Tympan/Earpiece_BTE-RIC_V1/ReadMe.md

# Tympan Behind The Ear Units

This repo contains hardware designs for Tympan compatible BTE units.
