Tympan/Earpiece_BTE-RIC_V1/Electrical Design/KICAD_ BTE_FLEX/Amphenol 10062827-1273992 Design Spec.pdf

PDM: Rev:C | Released | . STATUS: | Printed: Nov 28, 2010
