Tympan/Earpiece_BTE-RIC_V1/Electrical Design/KICAD_ BTE_FLEX/Tympan BTE Flex.png

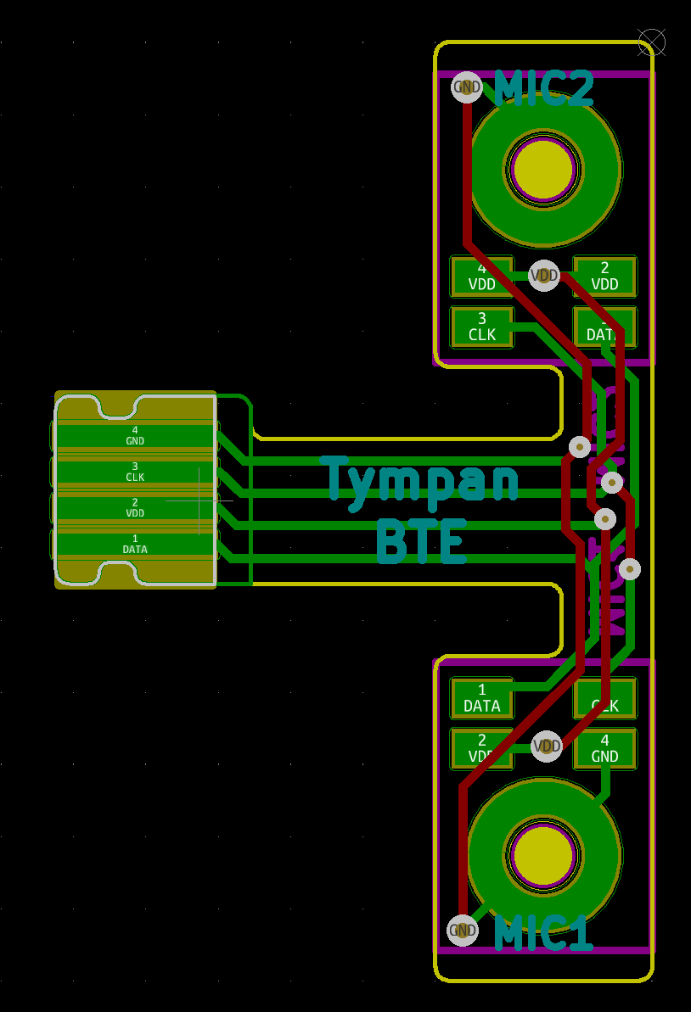
Electrical Design/KICAD_ BTE_FLEX/Tympan BTE Flex.png
