Tympan/Earpiece_BTE-RIC_V1/Photos/Tympan_Earpieces_02.jpg

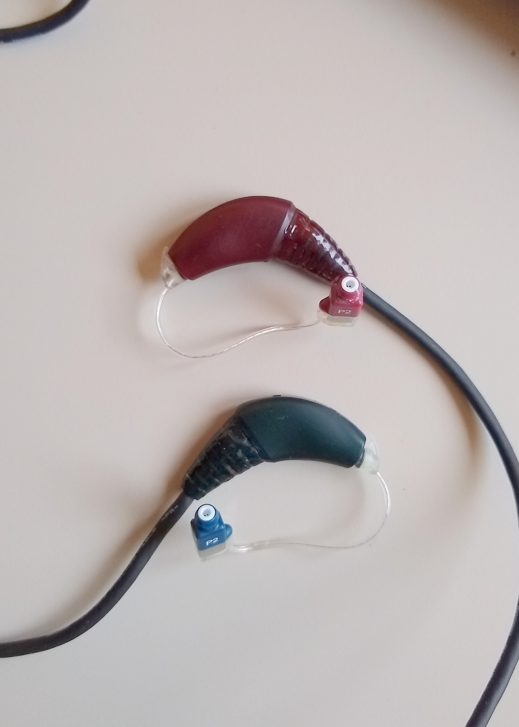
Photos/Tympan_Earpieces_02.jpg
