Tympan/Earpiece_BTE-RIC_V1/Photos/Tympan_Earpieces_04.jpg

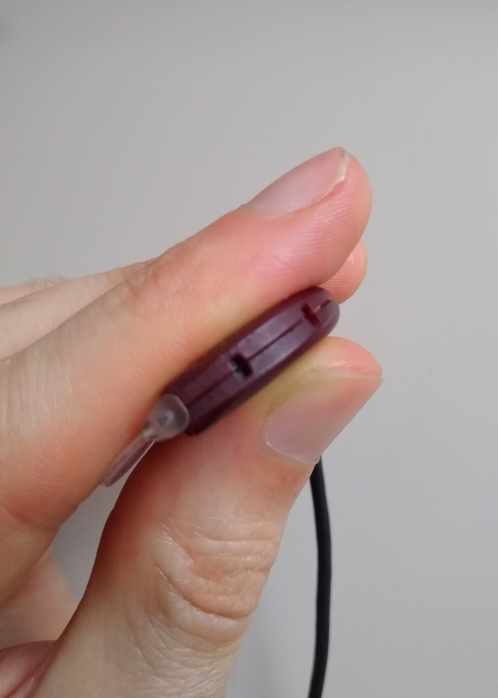
Photos/Tympan_Earpieces_04.jpg
