Tympan/Earpiece_BTE-RIC_V1/Renders/BTE-RIC-RevA.png

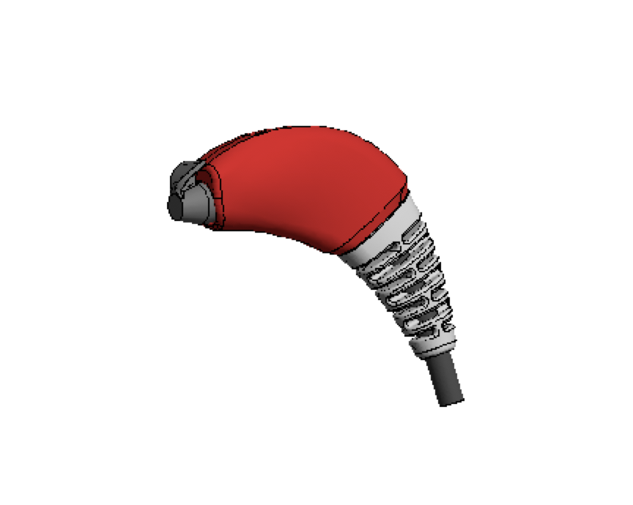
Renders/BTE-RIC-RevA.png
