Tympan/Earpiece_BTE-RIC_V1/Renders/Section_View_of_Mic_Ports.JPG

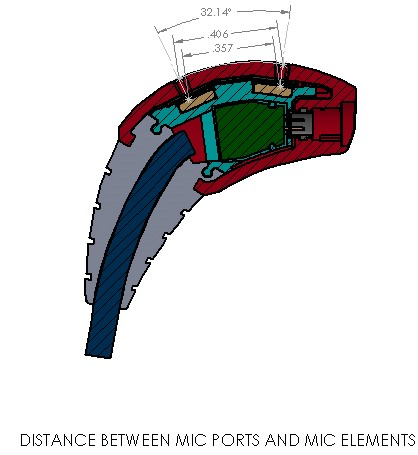
Renders/Section_View_of_Mic_Ports.JPG
