Tympan/Earpiece_BTE-RIC_V1/Renders/Tympan_BTE_Earpiece_Render-01.tif

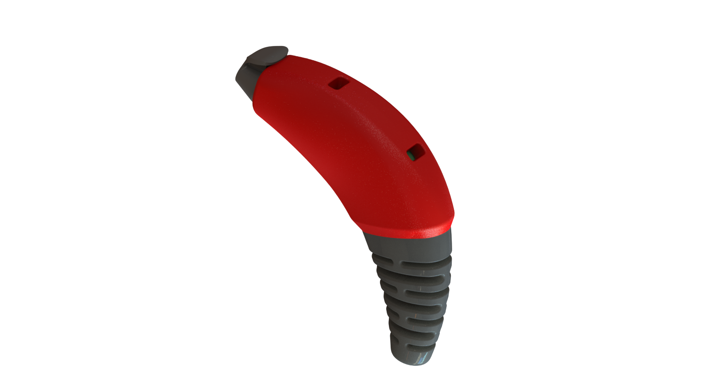
Renders/Tympan_BTE_Earpiece_Render-01.tif
