Tympan/Earpiece_BTE-RIC_V1/Renders/Tympan_BTE_Earpiece_Render-02.jpg

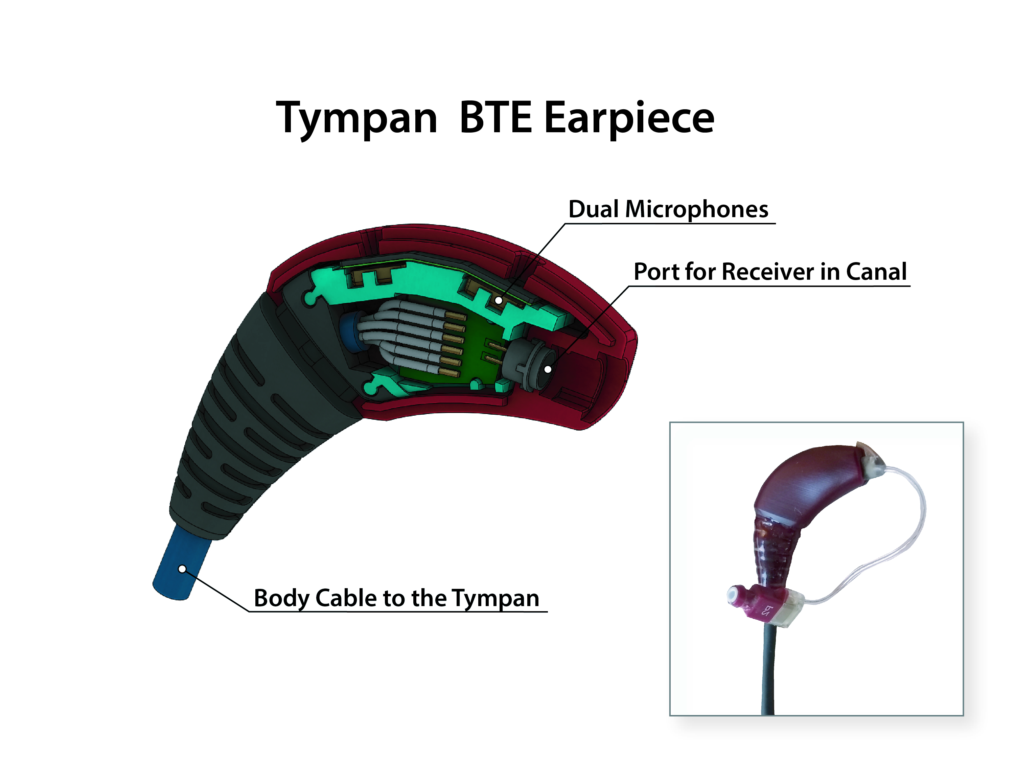
Renders/Tympan_BTE_Earpiece_Render-02.jpg
