Tympan/Earpiece_BTE-RIC_V1/Bill of Materials/BOM-7146-0100_BTE_Assembly.xlsx

Bill of Materials
BTE Earpieces
Project: Cool-Aid
Creare
Revision: C
Revised: 3/1/2021
Approved: EYUAN
Bill of Materials
Line | P/N | Description | Rev | Status | Manufacturer | Manuf. P/N | Vendor | Vendor P/N | Contact | Cost | QT per Earpiece | Notes
1 | 7146-01000 | BTE Assembly | B |  |  |  |  |  |  |  | 1
2 | 7146-01014 | BTE Enclosure_Left | A |  |  |  |  |  |  |  | 1
3 | 7146-01015 | BTE Enclosure_Right | B |  |  |  |  |  |  |  | 1
4 | 7146-01008 | Plastic Carrier | 0.1 |  |  |  |  |  |  |  | 1
5 | 7146-01003 | BTE Flex Circuit | E |  |  |  |  |  |  |  | 1 | 0.12mm thickness
6 | 7146-01017 | Mic_PDM | - |  | Infineon | IM69D130V01XTSA1 | Mouser | 726-IM69D130V01XTSA1 |  | $2.20 | 2
7 | 7146-01006 | Mic Gasket | D |  |  |  |  |  |  |  | 1
8 | 7146-01007 | BTE Rigid PCB Assy | C |  |  |  |  |  |  |  | 1
9 | 7146-01005 | Receiver Socket_CS44_PCBMount_RigidHousing12_BLK | - |  | Sonion | 4400-3112255 | Sonion | 4400-3112255 | Greg Hovland ggh@sonion.com Mobile: +1 507-269-8395 | $2.59 | 1 | PCB pins
10 | 7146-01013 | FPC Connector_4pos_0p5 pitch | - |  | Amphenol | 10062827-0410EDHLF (https://www.amphenol-icc.com/flex-0-5-vlp-100628270410edhlf.html) | Mouser | 649-100628270410EDHL (https://www.mouser.com/ProductDetail/Amphenol-FCI/10062827-0410EDHLF) |  | $0.28 | 1
11 | 7146-01008 | Body Cable Assy | H |  |  |  |  |  |  |  | 1
12 | 7146-01011 | USB Mini-B Connector_5-wire_Shielded | -
13 | 7146-01004 | Body Cable_6pos_33AWG_2.5mmOD | - |  | Mogami | W2880 | Redco | W2880 (https://www.redco.com/Mogami-W2880.html) | Phil Tennison phil@mogamicable.com Office: 310-333-0606 x 1112 Cell: 310-469-2890 | $0.85 | 3ft | Redco currently has 1000ft stock with no min order
14a | 7146-01001 | RIC_Knowles_FK Series_Size2_Right_WindScreen | - |  | Knowles | RVA-90020-NXX | In’Tech | 99A-3048106001 |  | $36.44 | 1 | 118ohm @1kHz: High Bandwidth
14b | 7146-01002 | RIC_Knowles_FK Series_Size2_Left_WindScreen | - |  | Knowles | RVA-90020-NXX | In’Tech | 99A-3048106002 |  | $36.44 | 1 | 118ohm @1kHz: High Bandwidth
15 | 7146-01016 | RIC Dome_Medium | - |  | N/A | N/A | In’Tech | 99A-1095426000 |  | $1.00 | 1
