Tympan/Earpiece_BTE-RIC_V1/Electrical Design/KICAD_ BTE_FLEX/Tympan_BTE_Flex_BOM.csv

Reference | Quantity | Value | Footprint | Manufacturer | Part Number
MIC1 MIC2 | 2 | IM69D130 | Tympan_BTE_Flex:IM69D130 | Infineon | IM69D130V01XTSA1
