Tympan/Earpiece_BTE-RIC_V1/Photos/Tympan_Earpiece_Components.jpg

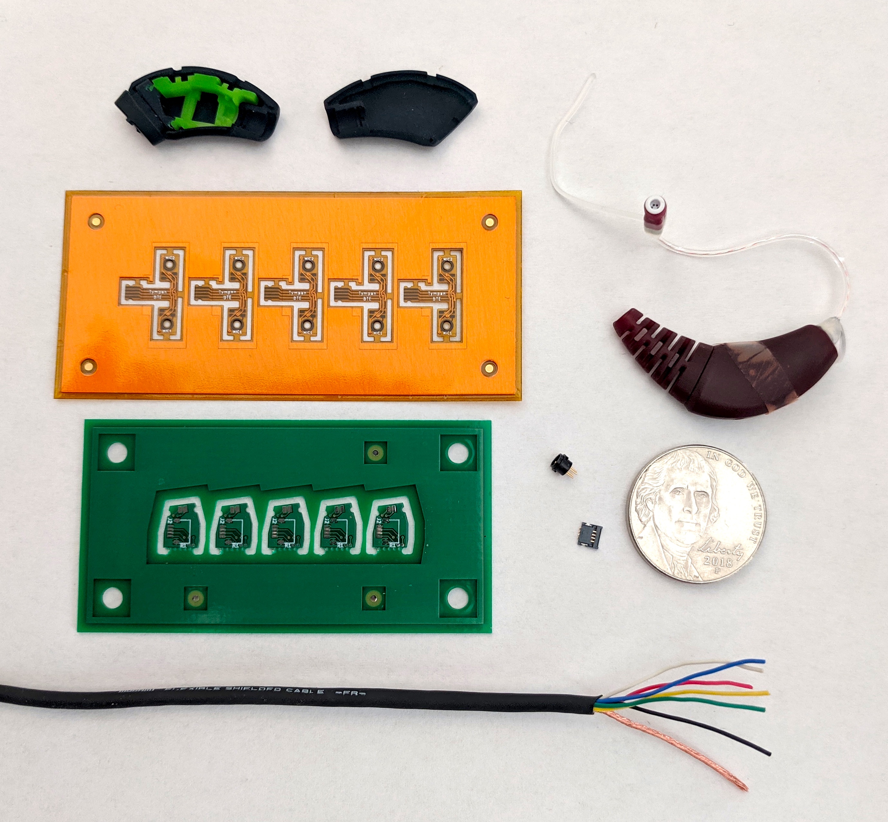
Photos/Tympan_Earpiece_Components.jpg
