Tympan/Earpiece_BTE-RIC_V1/Mechanical Design/Exported Geometry/7146-01006_MIC_GASKET__Rev-F.DXF

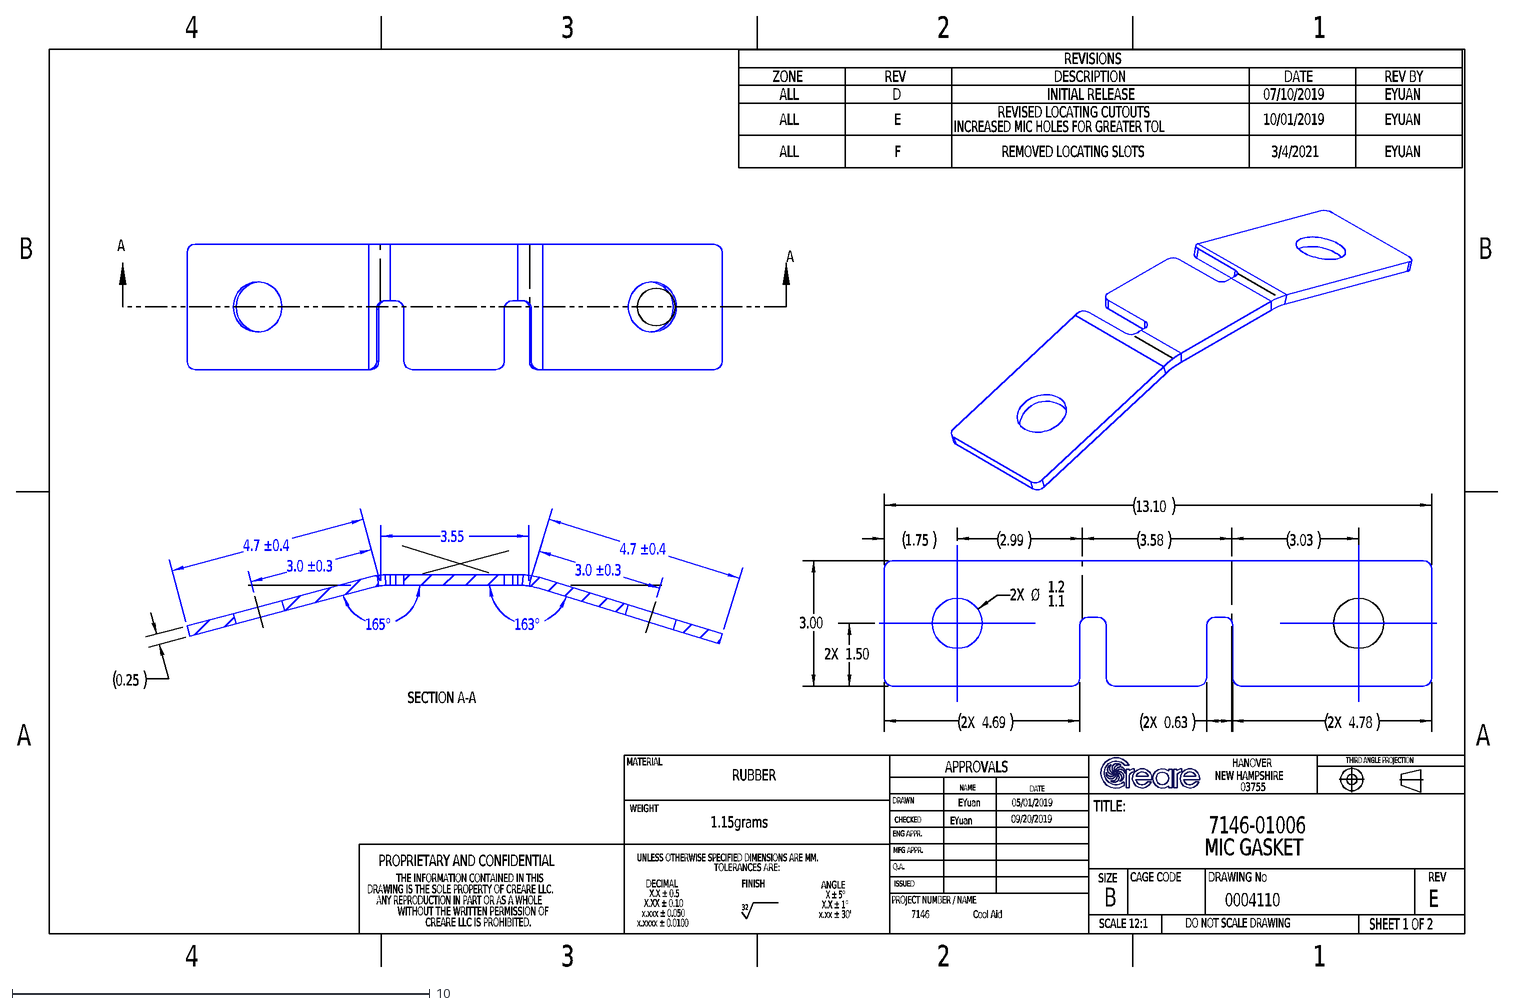
[picture p12: CAD file, 2021-03-08]
Mechanical Design/Exported Geometry/7146-01006_MIC_GASKET__Rev-F.DXF
03755
NEW HAMPSHIRE
HANOVER
APPROVALS
CAGE CODE
NAME
DATE
THE INFORMATION CONTAINED IN THIS
DRAWING IS THE SOLE PROPERTY OF CREARE LLC.
ANY REPRODUCTION IN PART OR AS A WHOLE
WITHOUT THE WRITTEN PERMISSION OF
CREARE LLC IS PROHIBITED.
PROPRIETARY AND CONFIDENTIAL
WEIGHT
MATERIAL
DRAWN
CHECKED
ENG APPR.
MFG APPR.
Q.A.
ISSUED
TITLE:
SIZE
PROJECT NUMBER / NAME
THIRD ANGLE PROJECTION
DRAWING No
REV
E
DO NOT SCALE DRAWING
SCALE 12:1
B
7146-01006
MIC GASKET
09/20/2019
EYuan
1.15grams
RUBBER
SHEET 1 OF 2
05/01/2019
0004110
7146
Cool Aid
DECIMAL
X.X ± 0.5
X.XX ± 0.10
x.xxx ± 0.050
x.xxxx ± 0.0100
UNLESS OTHERWISE SPECIFIED DIMENSIONS ARE MM.
TOLERANCES ARE:
FINISH
32
ANGLE
X ± 5°
X.X ± 1°
x.xx ± 30'
A
4
3
2
1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
