Tympan/Earpiece_BTE-RIC_V1/Mechanical Design/Exported Geometry/7146-01008_STRAIN_RELIEF__Rev-I.STEP

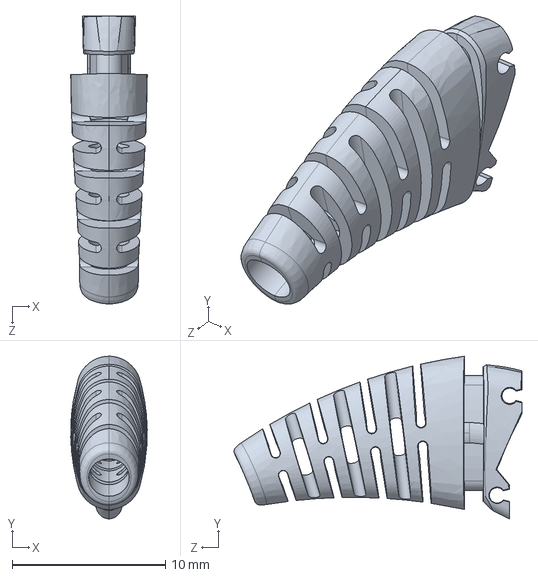
[picture p13: CAD file, 2021-03-04]
Mechanical Design/Exported Geometry/7146-01008_STRAIN_RELIEF__Rev-I.STEP
4.99 x 10.6 x 18.8 mm
