Tympan/Earpiece_BTE-RIC_V1/Mechanical Design/Exported Geometry/7146-01007_PCB FOR BTE__Rev-D.dxf

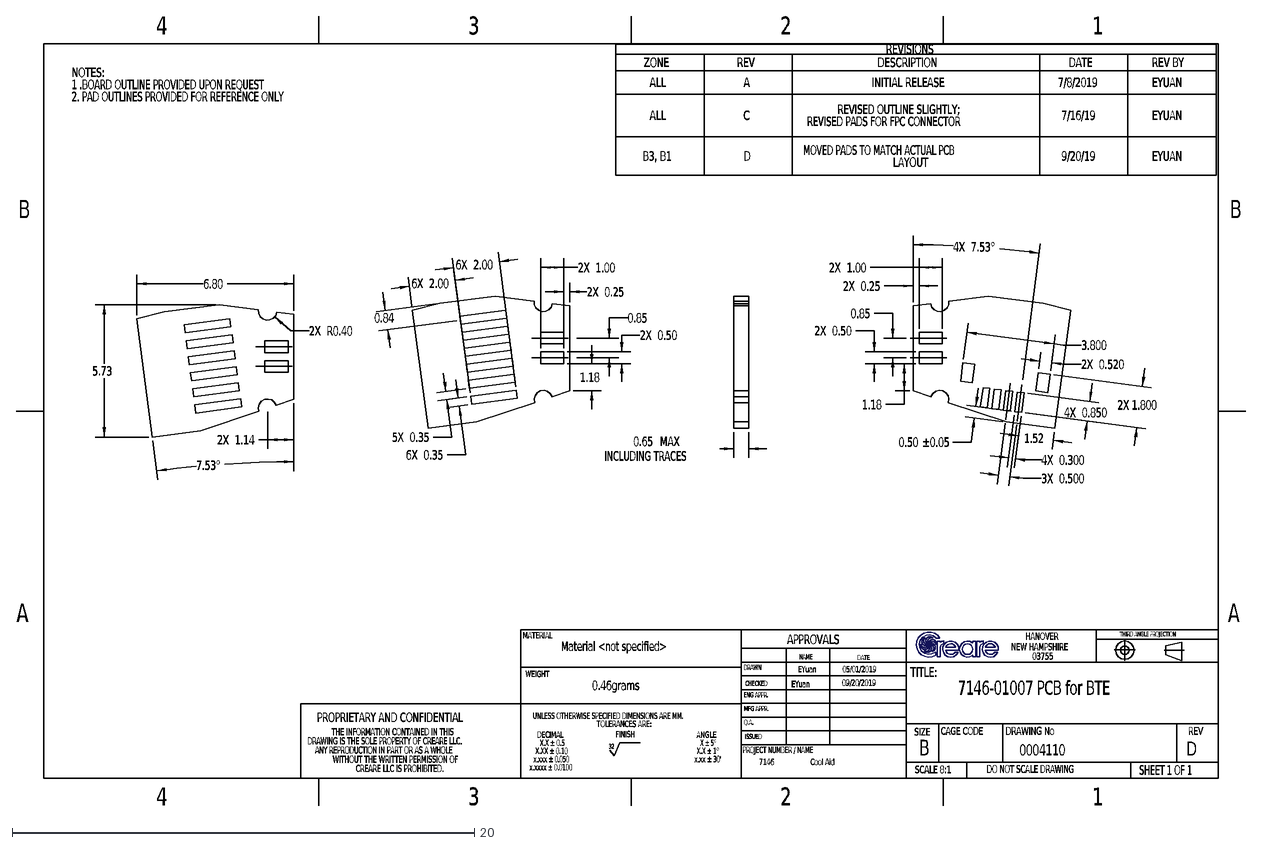
[picture p14: CAD file, 2019-09-20]
Mechanical Design/Exported Geometry/7146-01007_PCB FOR BTE__Rev-D.dxf
03755
NEW HAMPSHIRE
HANOVER
APPROVALS
CAGE CODE
NAME
DATE
THE INFORMATION CONTAINED IN THIS
DRAWING IS THE SOLE PROPERTY OF CREARE LLC.
ANY REPRODUCTION IN PART OR AS A WHOLE
WITHOUT THE WRITTEN PERMISSION OF
CREARE LLC IS PROHIBITED.
PROPRIETARY AND CONFIDENTIAL
WEIGHT
MATERIAL
DRAWN
CHECKED
ENG APPR.
MFG APPR.
Q.A.
ISSUED
TITLE:
SIZE
PROJECT NUMBER / NAME
THIRD ANGLE PROJECTION
DRAWING No
REV
NOTES:
1 .BOARD OUTLINE PROVIDED UPON REQUEST
2. PAD OUTLINES PROVIDED FOR REFERENCE ONLY
A
B
4
3
2
1
DO NOT SCALE DRAWING
SCALE 8:1
7146-01007 PCB for BTE
09/20/2019
EYuan
0.46grams
Material <not specified>
SHEET 1 OF 1
05/01/2019
0004110
7146
Cool Aid
D
DECIMAL
X.X ± 0.5
X.XX ± 0.10
x.xxx ± 0.050
x.xxxx ± 0.0100
UNLESS OTHERWISE SPECIFIED DIMENSIONS ARE MM.
TOLERANCES ARE:
FINISH
32
ANGLE
X ± 5°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
