Tympan/Earpiece_BTE-RIC_V1/Mechanical Design/Exported Geometry/7146-01015_ENCLOSURE_RIGHT__Rev-C_Imported as STP.sldprt

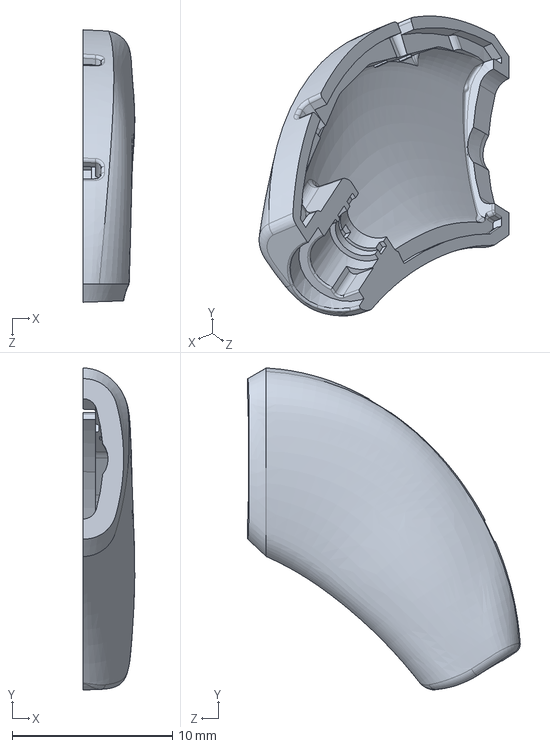
[picture p15: CAD file, 2019-07-24]
Mechanical Design/Exported Geometry/7146-01015_ENCLOSURE_RIGHT__Rev-C_Imported as STP.sldprt
3.21 x 20.1 x 17.0 mm
