Tympan/Earpiece_BTE-RIC_V1/Mechanical Design/Exported Geometry/7146-01014_ENCLOSURE_LEFT__Rev-A.step

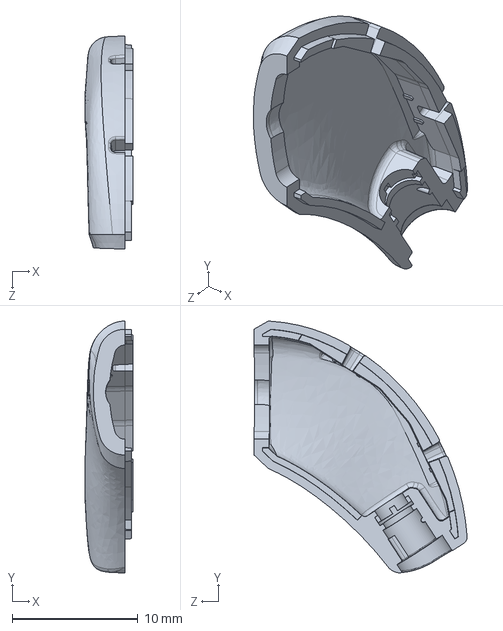
[picture p17: CAD file, 2019-07-11]
Mechanical Design/Exported Geometry/7146-01014_ENCLOSURE_LEFT__Rev-A.step
3.86 x 20.1 x 17.0 mm
