Tympan/Earpiece_BTE-RIC_V1/Mechanical Design/Exported Geometry/7146-01008 STRAIN RELIEF__Rev-B.dxf

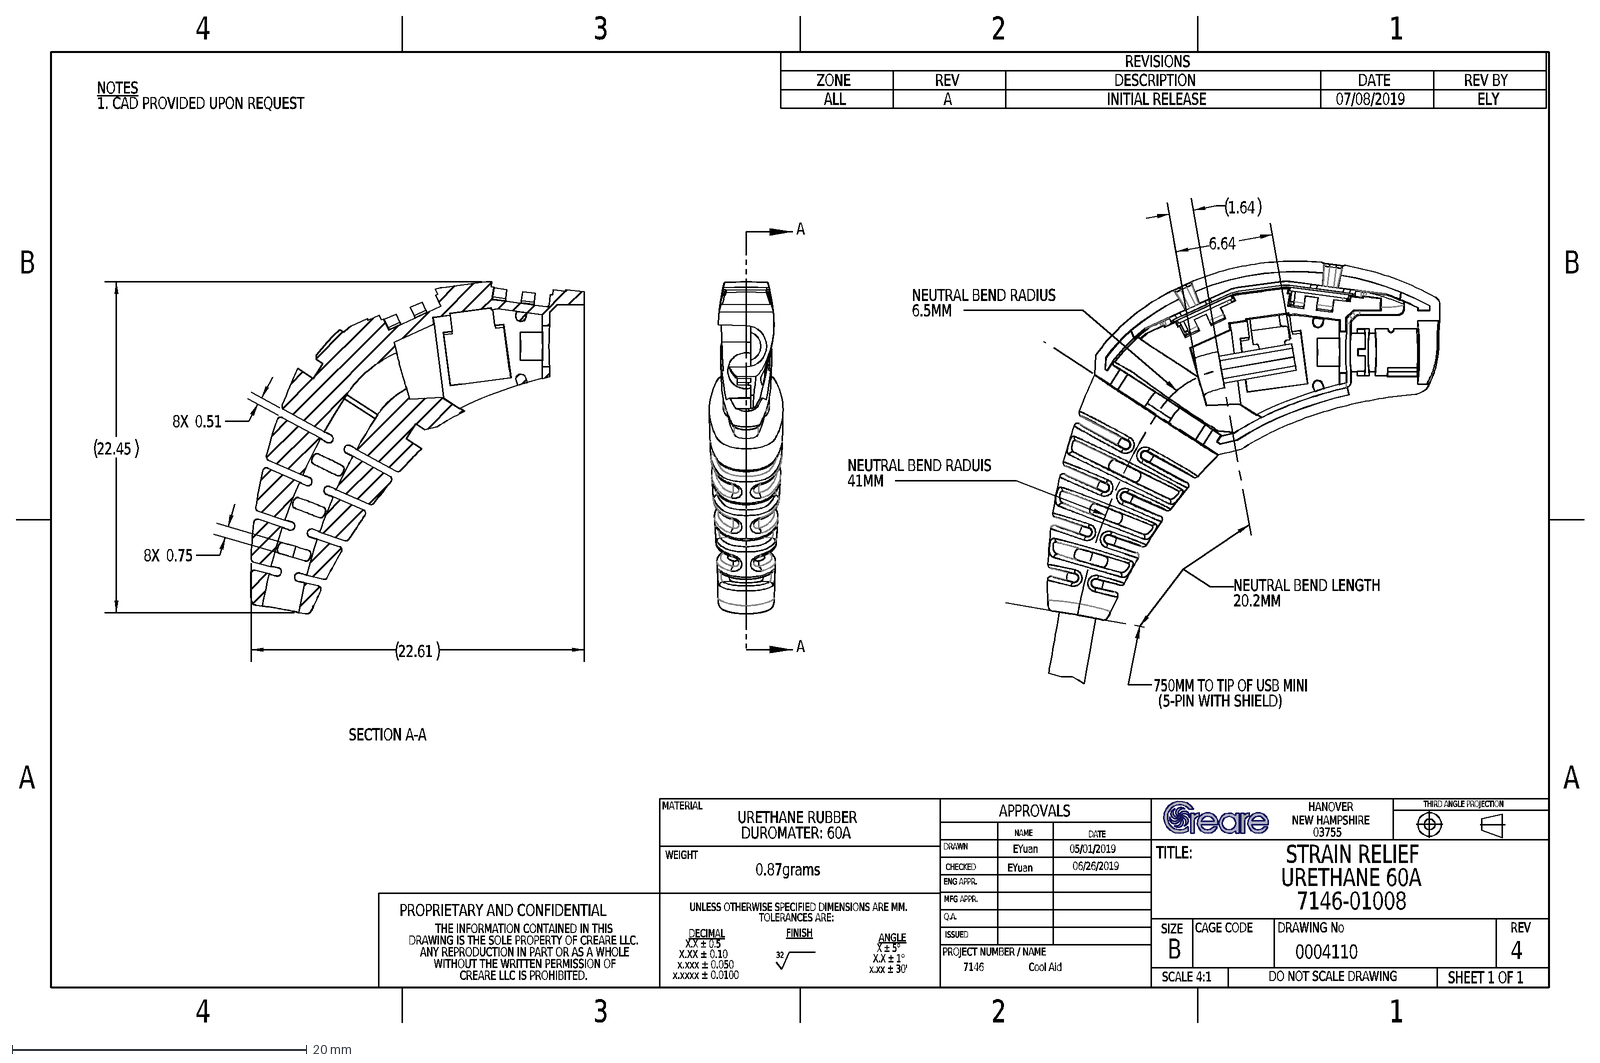
[picture p18: CAD file, 2019-07-11]
Mechanical Design/Exported Geometry/7146-01008 STRAIN RELIEF__Rev-B.dxf
03755
NEW HAMPSHIRE
HANOVER
APPROVALS
CAGE CODE
NAME
DATE
THE INFORMATION CONTAINED IN THIS
DRAWING IS THE SOLE PROPERTY OF CREARE LLC.
ANY REPRODUCTION IN PART OR AS A WHOLE
WITHOUT THE WRITTEN PERMISSION OF
CREARE LLC IS PROHIBITED.
PROPRIETARY AND CONFIDENTIAL
WEIGHT
MATERIAL
DRAWN
CHECKED
ENG APPR.
MFG APPR.
Q.A.
ISSUED
TITLE:
SIZE
PROJECT NUMBER / NAME
THIRD ANGLE PROJECTION
DRAWING No
REV
NOTES
1. CAD PROVIDED UPON REQUEST
4
DO NOT SCALE DRAWING
SCALE 4:1
B
STRAIN RELIEF
URETHANE 60A
7146-01008
06/26/2019
EYuan
0.87grams
URETHANE RUBBER
DUROMATER: 60A
SHEET 1 OF 1
05/01/2019
0004110
7146
Cool Aid
A
3
2
1
DECIMAL
X.X ± 0.5
X.XX ± 0.10
x.xxx ± 0.050
x.xxxx ± 0.0100
UNLESS OTHERWISE SPECIFIED DIMENSIONS ARE MM.
TOLERANCES ARE:
FINISH
32
ANGLE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
