Tympan/Earpiece_BTE-RIC_V1/(list of files, cad)

Other CAD files:
Mechanical Design/Exported Geometry/7146-01015_ENCLOSURE_RIGHT__Rev-C.step
Mechanical Design/Exported Geometry/7146-01015_ENCLOSURE_RIGHT__Rev-C.igs
