Tympan/Earpiece_BTE-RIC_V1/Assembly Guide/assets/cable-carrier-clamshell-dryFit_1.jpg

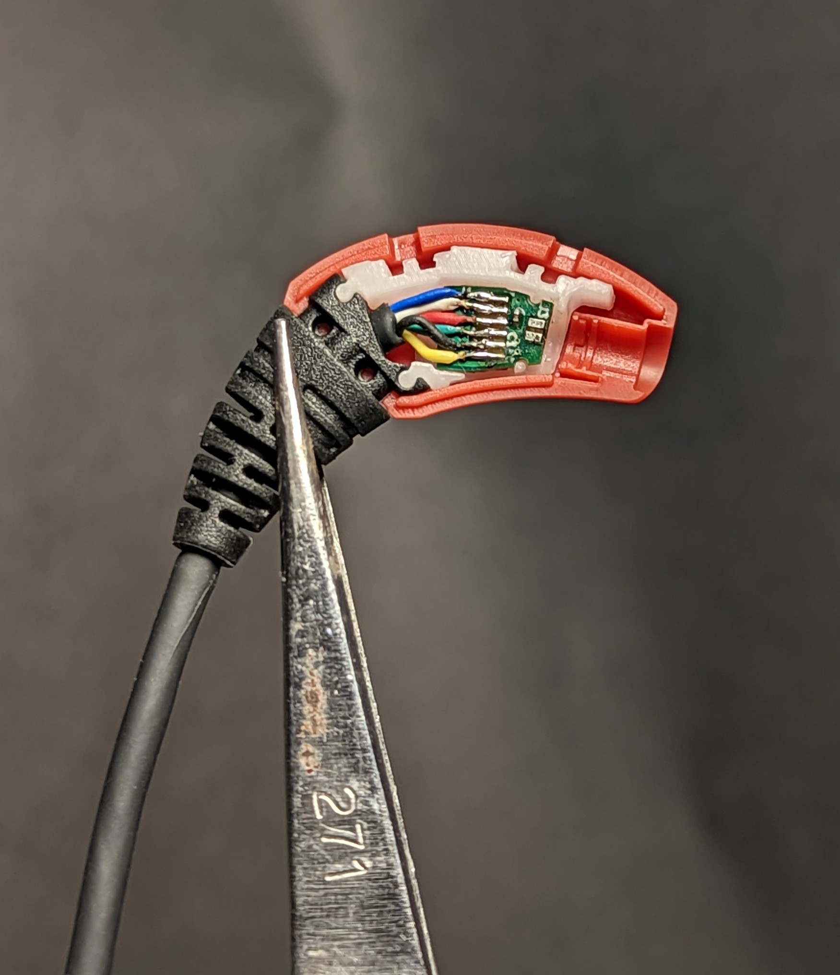
Assembly Guide/assets/cable-carrier-clamshell-dryFit_1.jpg
