Tympan/Earpiece_BTE-RIC_V1/(threads)

Thread 1 (2019-09-17):

Error in 7146-01003_FLEX CIRCUIT_Rev-E.PDF

biomurph, 2019-09-17:
It seems that there are incorrect dimensions in the drawing of the flex pcb. The same issue is in the DXF file. It has to do with the width of the area of major bending, and the position of the edges of the major bend area.

The listed width of the major bend area is 2.202mm.
From the bottom edge of the board to the bottom edge of the major bend area is listed as 5.532.

That makes the overall height of the board 13.266mm, which is 0.016 over the plus/minus tolerance.

In KiCad, I have the board outline laid out to match the DXF import, and I find that the width of the major bend area is more like 2mm, not 2.202mm.
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

erk1313, 2019-09-17:
The flex width overall and the flex width at the bend are independent dimensions.

For example, the flex width at the bend could be anywhere from 2-2.20mm.  If you found the die tends to make things smaller, the toolmaker might make the die 2.2mm wide to account for that.  That doesn't mean the overall width needs to increase to 13.2mm.  It can still remain 13mm and still pass the drawing's tolerance.

 If it did increase to 2.2mm, then the far side of that section (which is not dimensioned) would be at 5.532+2.2mm=7.732mm, which would be fine, and would also not bump out the overall width

biomurph, 2019-09-17:
OK, thanks for the clarification on that. I will be moving traces and vias around and if I need the 0.2 extra width it may come in handy.

Closed 2019-09-17.

Thread 2 (2019-09-19):

Add cap and resistor

erk1313, 2019-09-19:
Add (1) cap and (1) terminating resistor to the PCB inside the ear piece.
See [Wiring Diagram_RIC Hearing Aid_Rev-B.pdf](https://github.com/Tympan/Earpiece_BTE-RIC_V1/blob/master/Electrical%20Design/Schematics_PDF/Wiring%20Diagram_RIC%20Hearing%20Aid_Rev-B.pdf)

biomurph, 2019-09-19:
On it!

erk1313, 2019-09-19:
@biomurph  Sorry, these components go on the PCB not the flex.  I forgot.

Closed 2019-09-19.

Thread 3 (2019-09-19):

Verify flex thickness where the mics are mounted

erk1313, 2019-09-19:
I need to allow the proper gap between the face of the mic and the enclosure wall.  What is the thickness of the flex where the mics are mounted?

biomurph, 2019-09-19:
We get to define the thickness of the flex pcb. you have it spec'd out at 0.12+/-0.03 and so that's what I'm shooting for. Does that dimension still hold?

erk1313, 2019-09-19:
Yes.  works for me.

Closed 2019-09-19.

Thread 4 (2019-09-20):

Review BTE Rigid Board Design

erk1313, 2019-09-20:
- [x] Check board edges
- [x] Check routing and schematic: Speaker polarity was wrong.  Created issue #5

Otherwise ready to go!

erk1313, 2019-09-20:
Board edges line up great.
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

erk1313, 2019-09-20:
Pads for FPC connector were shifted a bit, which makes sense--they needed more room for the board margin.
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
 I revised the part in SW an updated the drawing.  Outlines now match
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

erk1313, 2019-09-20:
Pin order of the body cable was different than in my wiring diagram.  Eric will correct the wiring diagram.
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

erk1313, 2019-09-20:
Routing of wires is correct (other than speaker - and speaker + was swapped).  See issue #5

erk1313, 2019-09-20:
Should there be a BOM and a pick and place table?  Created issue #7

biomurph, 2019-09-20:
I had to swap the wire order to ease routing.
Are you are able to make the changes on your end to the slight offset of my layout?

erk1313, 2019-09-20:
Review complete

erk1313, 2019-09-20:
Yes, corrected it on my end (Issue #9)

Closed 2019-09-20.

Thread 5 (2019-09-20):

BTE Rigid PCB: Swap labels for speaker polarity

erk1313, 2019-09-20:
The speaker polarity is switched.  Change pin#4 to (-) and pin#3 to (+)
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

biomurph, 2019-09-20:
Oh dang. I stared at that one too long.

biomurph, 2019-09-20:
At least it won't require any re-routing, just a net swap.

biomurph, 2019-09-20:
and, done

Closed 2019-09-20.

Thread 6 (2019-09-20):

Rigid PCB: Label color of body cable leads

erk1313, 2019-09-20:
Should we label the color of the body cable leads on the schematic?  Just for reference.

Would the PCB house be willing to solder these leads to the PCB?  Would they have better tools for that than us?

biomurph, 2019-09-20:
Yes, assigning color to the connections on the schematic is a good idea.

I will be doing the assembly in-house, with my badass tools!

biomurph, 2019-09-20:
Done

Closed 2019-09-20.

Thread 7 (2019-09-20):

Rigid PCB: Missing BOM and Pick place table

erk1313, 2019-09-20:
Should there be a BOM and a pick place table?

biomurph, 2019-09-20:
I am going to do the assembly in-house. It's much easier to manage small tolerance issues when building up a bare board.

erk1313, 2019-09-20:
NVM.

Closed 2019-09-20.

Thread 8 (2019-09-20):

Review BTE Flex design

erk1313, 2019-09-20:
Logging our past communication (Joel + Eric) and adding a few more checks
- [x] Outline
- [x] Distance between mic holes
- [x] Tail length: Note that the tail from Joel's flex outline is a little longer.  That’s because in Solidworks I modeled the minimum tail length.  You were right to make the tail a little longer.  Thank you for paying attention to detail. No change needed
- [X] Routing
- [X] Check pin order
- [X] Check that pads are located on the correct side (front vs back)

Looks good!

erk1313, 2019-09-20:
* Pads for mic are located correctly on the back side
* Checking pin order of the tail

biomurph, 2019-09-20:
- Checking pin order of the tail

Yes, please do. I stared at that for a long time too!

Closed 2019-09-20.

Thread 9 (2019-09-20):

Update wiring diagram to reflect the PCB layout

erk1313, 2019-09-20:
Existing conflict

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

erk1313, 2019-09-20:
Wiring Overview now matches expected PCB layout (Rev-C) 0a1c5d903f74177112570366a82be21907d3753e
* position of Speaker - and + were swapped
* position of VDD and CLK were swapped.

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

erk1313, 2019-09-20:
Wiring overview updated

Closed 2019-09-20.

Thread 11 (2019-09-24):

Suffix DXF is causing glitches

biomurph, 2019-09-24:
This may not be a critical issue, but the capitalization of DXF is causing a fail in KiCad when I try to import it into the board layout. The fix is to change the suffix from all caps to lower case. Not sure how your getting all caps in all of the suffixes that you've got in this repo, but some softwares might have issues with the all caps.

biomurph, 2020-09-10:
@eyuan-creare I am bringing this up again because my CM is having some hangup opening files.
I tried to change files suffix from caps to lower, but it does not change the repo enough for me to push up to the git.
Right now, I'm sending them zipped files to see if that helps. Can you change the suffixes for the mechanical and pdf files to lower case?

eyuan-creare, 2020-09-10:
@biomurph The file extensions were updated.  Note that I had to add an additional underscore to cause a changed to be detected.

Thread 13 (2020-07-07):

Develop a QA test that mitigates variability in mic and RIC sensitivity

eyuan-creare, 2020-07-07:

eyuan-creare, 2020-07-07:
Capturing @chipaudette 's feedback:
```
If anyone were to have to use the out-of-spec earpieces, yes, they would have to use our calibration model to account for the difference.  But, any Tympan example code that includes a calibration does not need to illustrate this weirdo case.  The example code should probably just illustrate the nominal case.

I would suggest, however, that we put some sort of label on the out-of-spec earpieces (around the cable?).  If we end up using that earpiece, the label would let us know that we need to manually adjust the calibration (or gain) values to compensate for its out-of-spec sensitivity.
```

eyuan-creare, 2020-07-07:
Joel could save the per-band calibration values in EEPROM.  Then we could add a #define in all the examples that evoke a correction to the sensitivity that happens behind the scenes so it doesn’t get in the way of the basic examples.  For instance, by adding a calibration patch cord to the Tympan library.

Thread 15 (2022-10-17):

Testing Firmware Needed

biomurph, 2022-10-17:
# Initial Issue Post
There is a need for testing the BTE units during production. The test should be simple, and result in a go/no-go result.
## Proposed Requirements

The test needs to be performed at different stages of the assembly process.

1. Upon connecting the Flex PCB
2. Upon fitting Mic Carrier
3. Upon 1/2 Clamshell assembly
4. Upon complete Clamshell assembly

Pseudo Code
1. Generate a 1kHz tone on the speaker output with a small speaker
5. Connect with the PDM microphones and patch them to inputs
    - Monitor the PDM inputs for the 1kHz tone
6. Generate a 1kHz tone on the RIC output
7. Connect the RIC to the MIC input of the Tympan
    - Monitor the Tympan MIC input for the 1kHz tone

Is this a sufficient to maintain quality?

biomurph, 2022-10-19:
Until there is assembly specific testing firmware, @eyuan-creare has proposed using the example sketch [EarpieceManualMixing_wSD.ino](https://github.com/Tympan/Tympan_Library/tree/main/examples/09-Earpieces/EarpieceManualMixing_wSD). This will provide the following test signals

- Front and Back earpiece mic will present on the Tympan speaker output. Verifiable with headphones
- RIC will output the audio that is picked up from the earpiece speakers. Verifiable by listening to RIC

biomurph, 2022-10-19:
@eyuan-creare
I just discovered this example in the Library !!
[OutputTone_wEarpieces.ino](https://github.com/Tympan/Tympan_Library/tree/main/examples/09-Earpieces/OutputTone_wEarpieces)
I will use it to verify the RIC functionality as a first step, then use the [EarpieceManualMixing_wSD.ino](https://github.com/Tympan/Tympan_Library/tree/main/examples/09-Earpieces/EarpieceManualMixing_wSD) to test microphone functionality during assembly.

Thread 16 (2022-10-19):

Top Of Production BTE Intake And Testing

biomurph, 2022-10-19:
# Final Assembly And Testing of BTE Units
This Issue will cover the process of testing the top of production BTE units.
On 10/14/2022, I received all of the parts for 10 complete units (5 pairs).
These units require final assembly, as we have had trouble with the mic inputs on previously delivered fully assembled units.

- The cables came assembled with the USB on one end and a strain relief with the BTE Rigid PCB soldered on the other end
   The assembly did not have the RIC connector (CS-44) placed. This was done in-house. All RIC connectors soldered and positioned well.

## First Test: RIC
The example sketch [OutputTone_wEarpieces.ino](https://github.com/Tympan/Tympan_Library/tree/main/examples/09-Earpieces/OutputTone_wEarpieces) was used to send a tone to the RIC. A passing test meant that the tone was audible when the RIC was held to the ear (not inserted in the ear canal).

- 10 of 10 PASS
