Tympan/Earpiece_BTE-RIC_V1/Electrical Design/Schematics_PDF/Wiring Diagram_RIC Hearing Aid_Rev-D.pdf

## Front Mic IM69D130

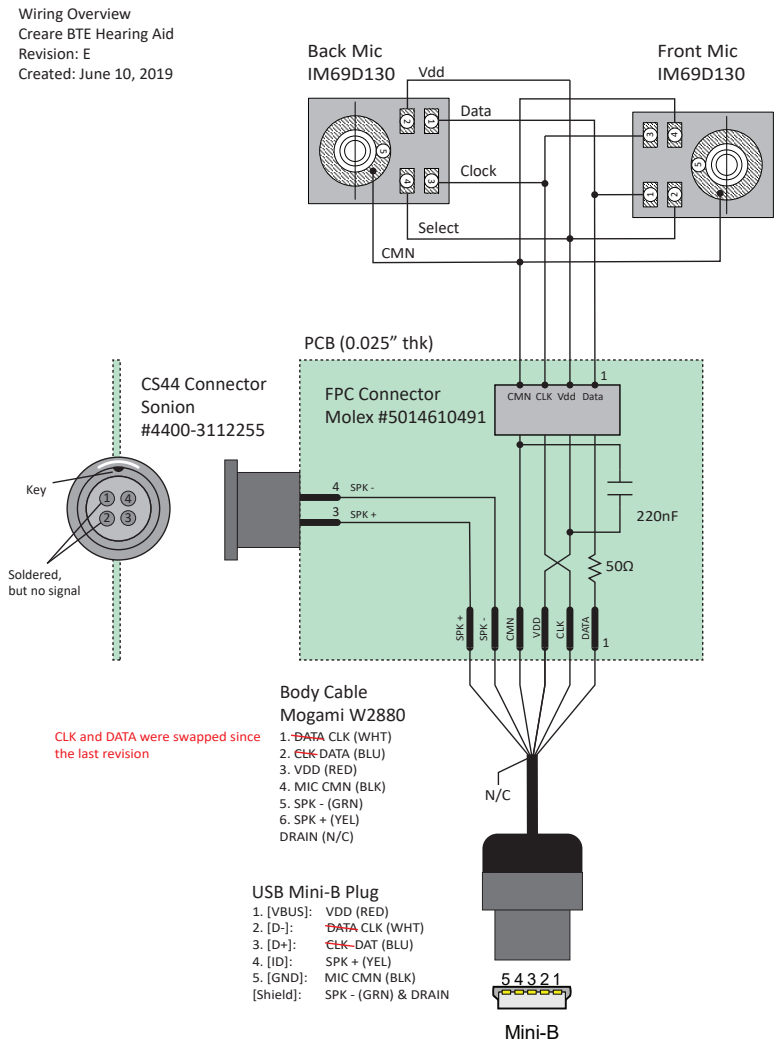
[picture p28: page 1]
Data; Vdd; Back Mic IM69D130; Select; CMN; Clock; CLK; SPK -; DATA; SPK +; VDD; FPC Connector Molex #5014610491; DATA CLK (WHT); CLK DAT (BLU); SPK + (YEL); [Shield]:; SPK - (GRN) & DRAIN; PCB (0.025” thk); CS44 Connector Sonion #4400-3112255; Mini-B; Key

Wiring Overview
Creare BTE Hearing Aid
Revision: E
Created: June 10, 2019

Soldered,
but no signal

Body Cable
Mogami W2880
1. DATA CLK (WHT)
2. CLK DATA (BLU)
3. VDD (RED)
4. MIC CMN (BLK)
5. SPK - (GRN)
6. SPK + (YEL)
DRAIN (N/C)

CLK and DATA were swapped since
the last revision

USB Mini-B Plug
1. [VBUS]: VDD (RED)
5. [GND]: MIC CMN (BLK)
