Tympan/Earpiece_BTE-RIC_V1/Mechanical Design/Drawings_PDF/7146-01007_PCB FOR BTE__Rev-D.pdf

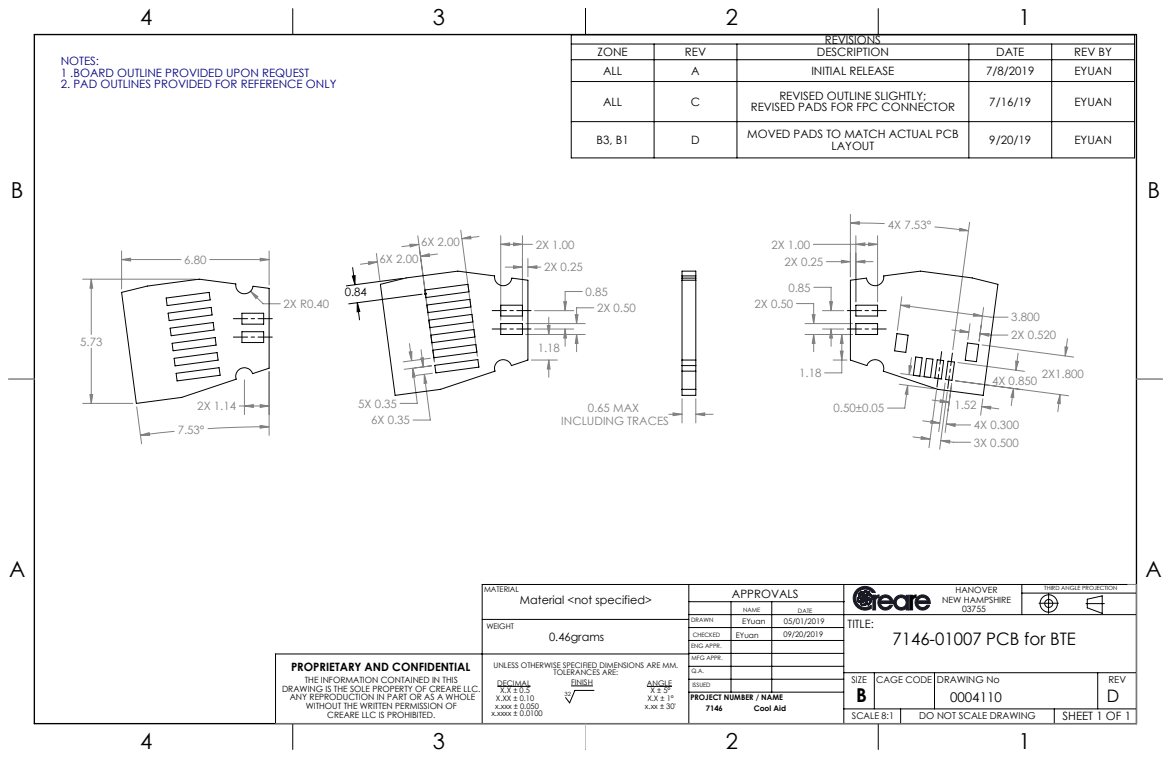
[picture p29: page 1]
NEW HAMPSHIRE APPROVALS; HANOVER; CAGE CODE; ENG APPR.; MFG APPR.; PROJECT NUMBER / NAME; DRAWING No; REV; 0.65 MAX INCLUDING TRACES; SCALE 8:1; DO NOT SCALE DRAWING; 7146-01007 PCB for BTE EYuan; 09/20/2019 0.46grams; SHEET 1 OF 1; 7146 Cool Aid; X.X ± 0.5 X.XX ± 0.10 x.xxx ± 0.050 x.xxxx ± 0.0100; UNLESS OTHERWISE SPECIFIED DIMENSIONS ARE MM. TOLERANCES ARE:

REVISIONS

ZONE | REV | DESCRIPTION | DATE | REV BY
ALL | A | INITIAL RELEASE | 7/8/2019 | EYUAN
ALL | C | REVISED OUTLINE SLIGHTLY; REVISED PADS FOR FPC CONNECTOR | 7/16/19 | EYUAN

NOTES:
1 .BOARD OUTLINE PROVIDED UPON REQUEST
2. PAD OUTLINES PROVIDED FOR REFERENCE ONLY

B3, B1 | D | MOVED PADS TO MATCH ACTUAL PCB LAYOUT | 9/20/19 | EYUAN

MATERIAL
Material <not specified>

THIRD ANGLE PROJECTION

PROPRIETARY AND CONFIDENTIAL
THE INFORMATION CONTAINED IN THIS
DRAWING IS THE SOLE PROPERTY OF CREARE LLC.
ANY REPRODUCTION IN PART OR AS A WHOLE
WITHOUT THE WRITTEN PERMISSION OF
CREARE LLC IS PROHIBITED.
