Tympan/Earpiece_BTE-RIC_V1/Mechanical Design/Drawings_PDF/7146-01003_FLEX CIRCUIT__Rev-E.pdf

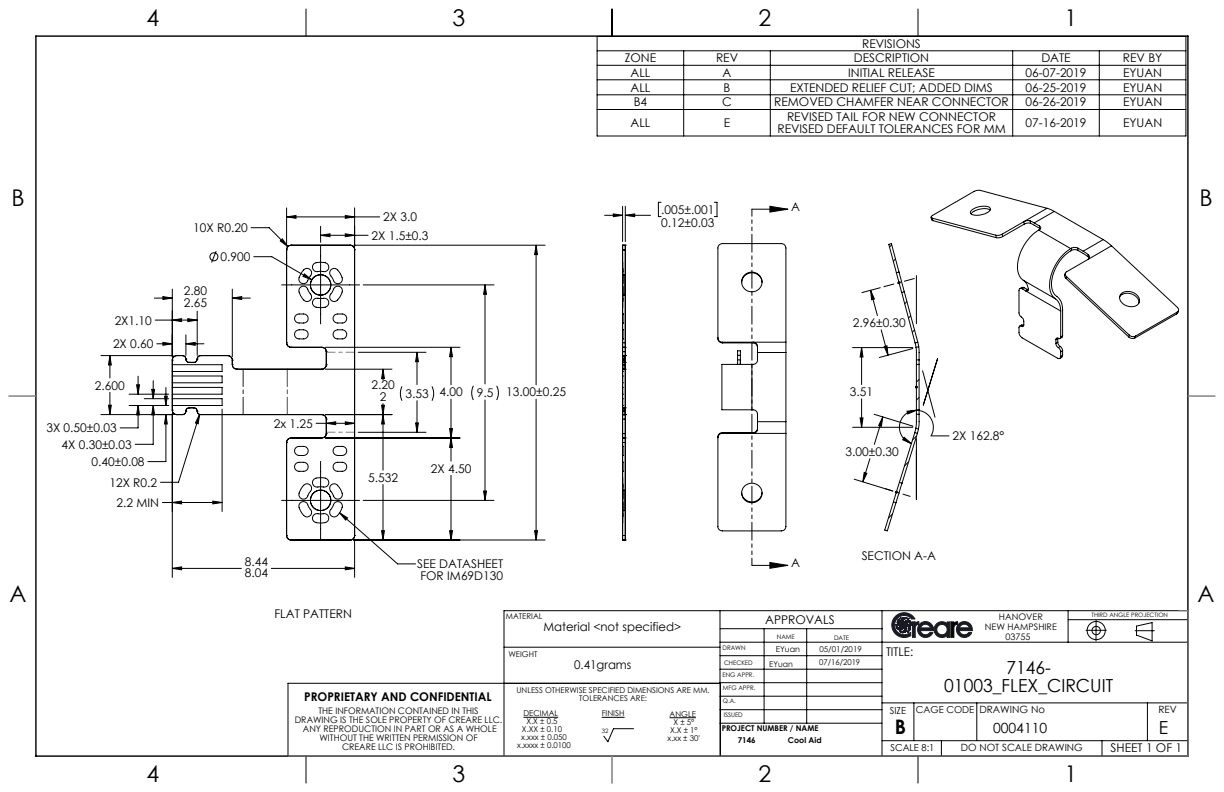
[picture p30: page 1]
TOLERANCES ARE:; X.X ± 0.5 X.XX ± 0.10 x.xxx ± 0.050 x.xxxx ± 0.0100; NEW HAMPSHIRE APPROVALS; HANOVER; CAGE CODE; ENG APPR.; MFG APPR.; PROJECT NUMBER / NAME; DRAWING No; REV; 2.2 MIN; SEE DATASHEET FOR IM69D130; SECTION A-A; FLAT PATTERN; SCALE 8:1; DO NOT SCALE DRAWING; EYuan; 07/16/2019 0.41grams; SHEET 1 OF 1; 7146 Cool Aid

REVISIONS

ZONE | REV | DESCRIPTION | DATE | REV BY
ALL | A | INITIAL RELEASE | 06-07-2019 | EYUAN
ALL | B | EXTENDED RELIEF CUT; ADDED DIMS | 06-25-2019 | EYUAN
B4 | C | REMOVED CHAMFER NEAR CONNECTOR | 06-26-2019 | EYUAN
ALL | E | REVISED TAIL FOR NEW CONNECTOR REVISED DEFAULT TOLERANCES FOR MM | 07-16-2019 | EYUAN

MATERIAL
Material <not specified>

THIRD ANGLE PROJECTION

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

UNLESS OTHERWISE SPECIFIED DIMENSIONS ARE MM.
