Tympan/Earpiece_BTE-RIC_V1/Mechanical Design/Drawings_PDF/7146-01008 STRAIN RELIEF__Rev-H.pdf

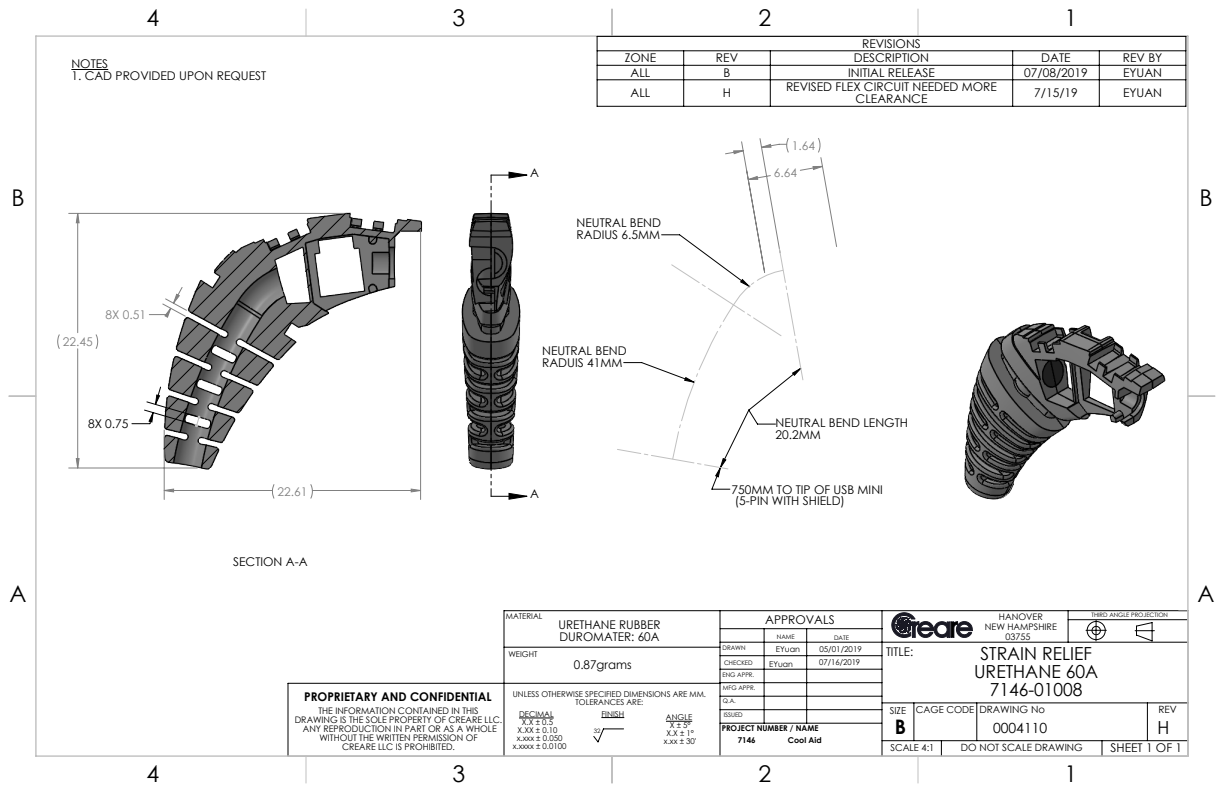
[picture p31: page 1]
NEW HAMPSHIRE APPROVALS; HANOVER; CAGE CODE; ENG APPR.; MFG APPR.; PROJECT NUMBER / NAME; DRAWING No; REV; NEUTRAL BEND RADIUS 6.5MM; NEUTRAL BEND RADUIS 41MM; SECTION A-A; SCALE 4:1; DO NOT SCALE DRAWING; STRAIN RELIEF URETHANE 60A; EYuan; 07/16/2019 0.87grams; URETHANE RUBBER DUROMATER: 60A; SHEET 1 OF 1; 7146 Cool Aid; X.X ± 0.5 X.XX ± 0.10 x.xxx ± 0.050 x.xxxx ± 0.0100; UNLESS OTHERWISE SPECIFIED DIMENSIONS ARE MM. TOLERANCES ARE:

REVISIONS

ZONE | REV | DESCRIPTION | DATE | REV BY
ALL | B | INITIAL RELEASE | 07/08/2019 | EYUAN
ALL | H | REVISED FLEX CIRCUIT NEEDED MORE CLEARANCE | 7/15/19 | EYUAN

NOTES
1. CAD PROVIDED UPON REQUEST

NEUTRAL BEND LENGTH

750MM TO TIP OF USB MINI
(5-PIN WITH SHIELD)

THIRD ANGLE PROJECTION

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
