Tympan/Earpiece_BTE-RIC_V1/Mechanical Design/Drawings_PDF/7146-01000_BTE ASSY__Rev-A.pdf

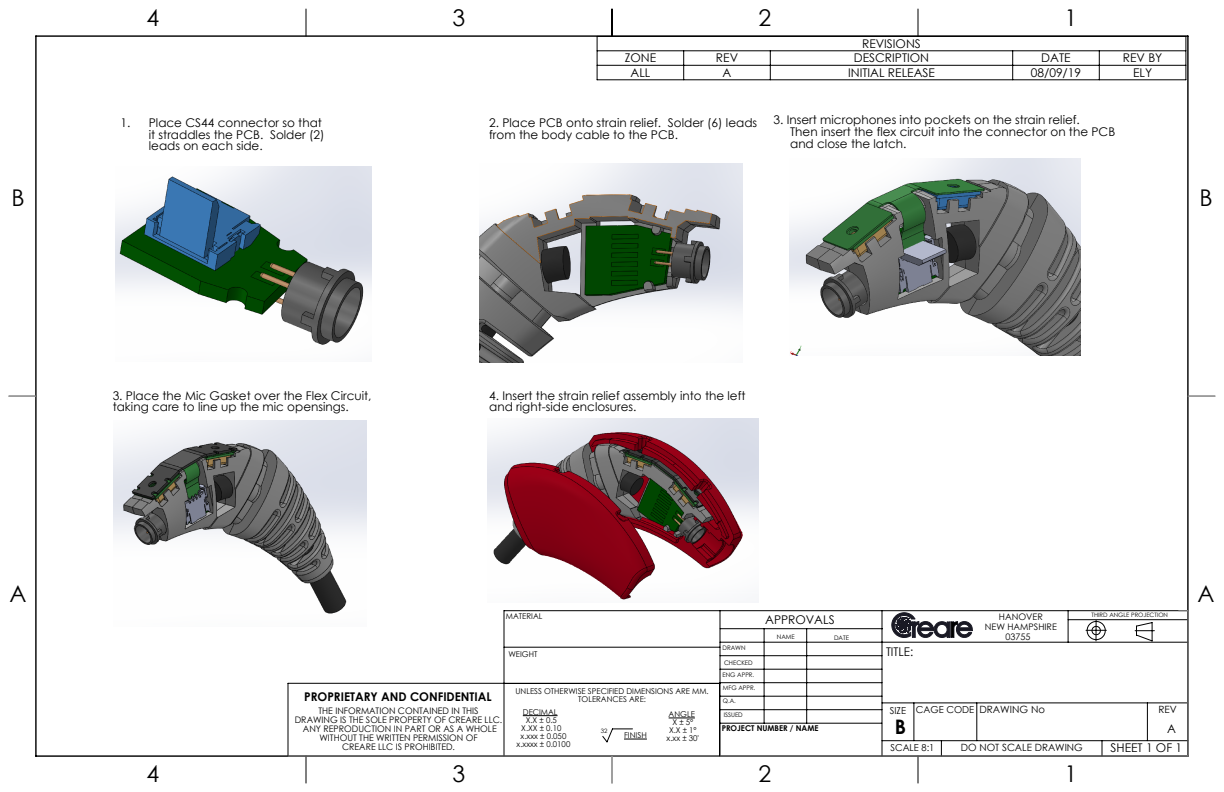
[picture p32: page 1]
NEW HAMPSHIRE APPROVALS; HANOVER; CAGE CODE; ENG APPR.; MFG APPR.; PROJECT NUMBER / NAME; DRAWING No; REV ANGLE; TOLERANCES ARE:; X.X ± 0.5 X.XX ± 0.10 x.xxx ± 0.050 x.xxxx ± 0.0100; SCALE 8:1; DO NOT SCALE DRAWING; SHEET 1 OF 1

REVISIONS

ZONE | REV | DESCRIPTION | DATE | REV BY
ALL | A | INITIAL RELEASE | 08/09/19 | ELY

1. Place CS44 connector so that
it straddles the PCB. Solder (2)
leads on each side.

2. Place PCB onto strain relief. Solder (6) leads
from the body cable to the PCB.

3. Insert microphones into pockets on the strain relief.
Then insert the flex circuit into the connector on the PCB
and close the latch.

3. Place the Mic Gasket over the Flex Circuit,
taking care to line up the mic opensings.

4. Insert the strain relief assembly into the left
and right-side enclosures.

THIRD ANGLE PROJECTION

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

UNLESS OTHERWISE SPECIFIED DIMENSIONS ARE MM.
