Tympan/Earpiece_BTE-RIC_V1/Mechanical Design/Drawings_PDF/7146-01006_MIC_GASKET__Rev-F.pdf

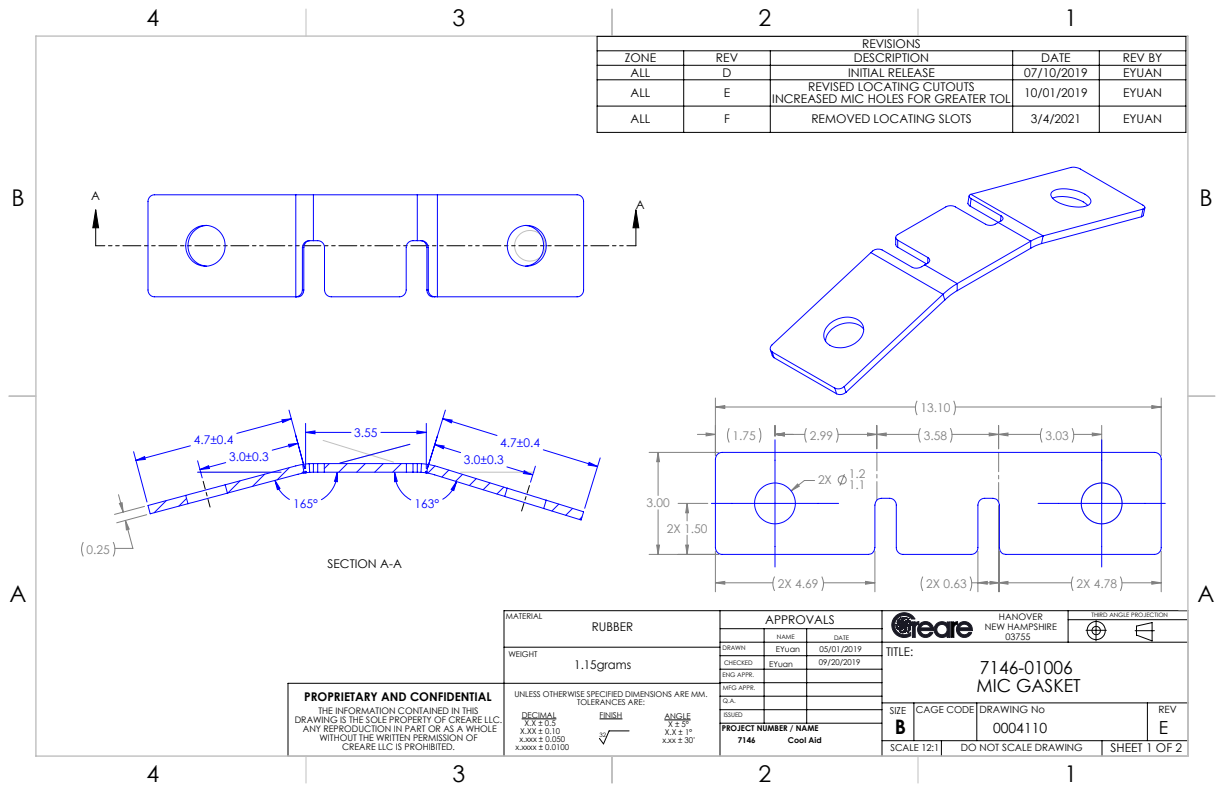
[picture p33: page 1]
NEW HAMPSHIRE APPROVALS; HANOVER; CAGE CODE; ENG APPR.; MFG APPR.; PROJECT NUMBER / NAME; DRAWING No; REV; SECTION A-A; SCALE 12:1; DO NOT SCALE DRAWING; MIC GASKET; EYuan; 09/20/2019 1.15grams; SHEET 1 OF 2; 7146 Cool Aid; X.X ± 0.5 X.XX ± 0.10 x.xxx ± 0.050 x.xxxx ± 0.0100; TOLERANCES ARE:

A | REVISIONS

ZONE | REV | DESCRIPTION | DATE | REV BY
ALL | D | INITIAL RELEASE | 07/10/2019 | EYUAN
ALL | E | REVISED LOCATING CUTOUTS INCREASED MIC HOLES FOR GREATER TOL | 10/01/2019 | EYUAN

ALL | F | REMOVED LOCATING SLOTS | 3/4/2021 | EYUAN

THIRD ANGLE PROJECTION

PROPRIETARY AND CONFIDENTIAL
THE INFORMATION CONTAINED IN THIS
DRAWING IS THE SOLE PROPERTY OF CREARE LLC.
ANY REPRODUCTION IN PART OR AS A WHOLE
WITHOUT THE WRITTEN PERMISSION OF
CREARE LLC IS PROHIBITED.

UNLESS OTHERWISE SPECIFIED DIMENSIONS ARE MM.

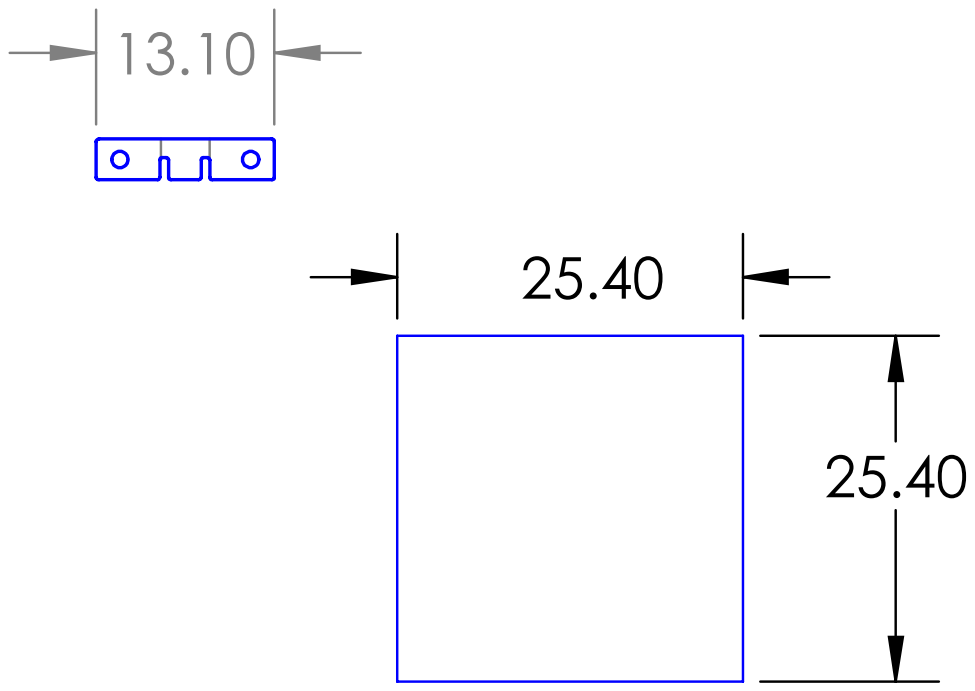
[picture p34: page 2]
