Tympan/Earpiece_BTE-RIC_V1/Electrical Design/KICAD_ BTE_FLEX/Tympan_BTE_Flex_Schematic.pdf

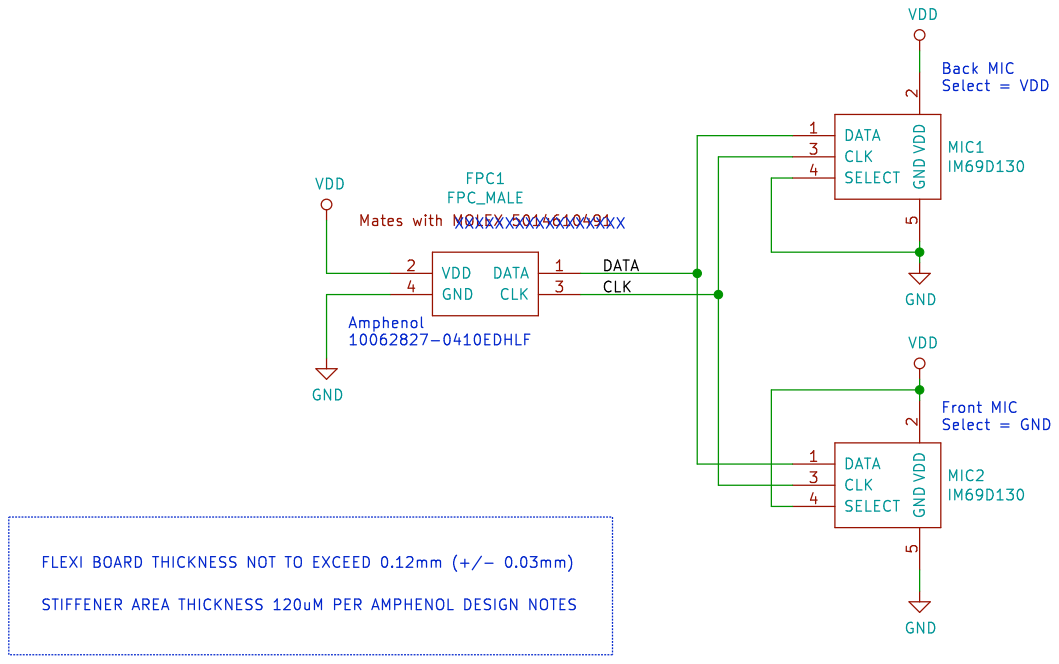
[picture p35: page 1]
