Tympan/Earpiece_BTE-RIC_V1/Electrical Design/KICAD_BTE_RIGID/Tympan_BTE_RIGID_Schematic.pdf

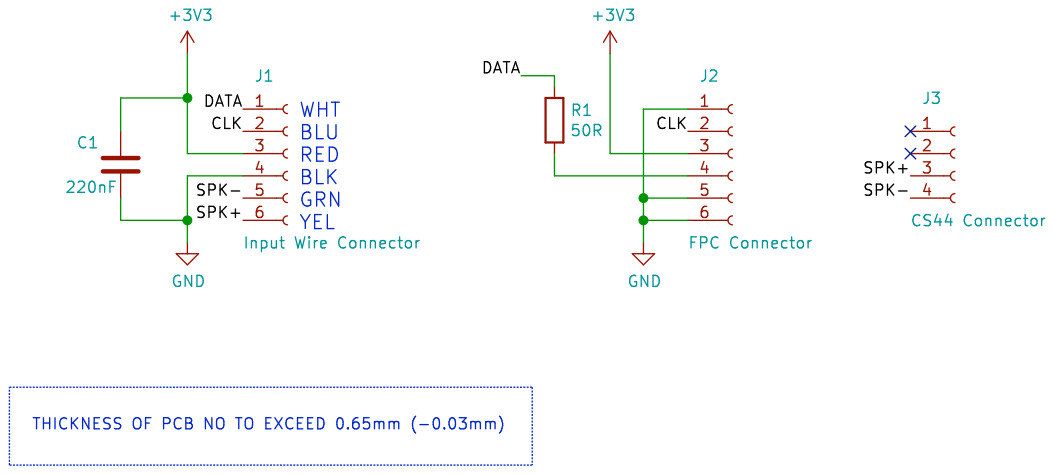
[picture p36: page 1]
