Tympan/Earpiece_BTE-RIC_V1/Electrical Design/KICAD_BTE_RIGID/Tympan_BTE_RIGID.kicad_pcb

## KiCad design Electrical Design/KICAD_BTE_RIGID/Tympan_BTE_RIGID.kicad_pcb (2019-09-20)

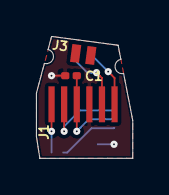
[picture p37: board Tympan_BTE_RIGID.kicad_pcb from above]

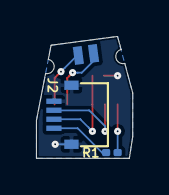
[picture p38: board Tympan_BTE_RIGID.kicad_pcb from below]

Board: 2 copper layers, 5.3 x 6.8 mm, 5 parts (2 on the bottom side), 7 nets.

Parts:
C1: 220nF; C_0201_0603Metric
J1: Input Wire Connector; BTE_INPUT
J2: FPC Connector; 10062827-0410EDHLF
J3: CS44 Connector; CS44
R1: 50R; R_0201_0603Metric

Connections:
+3V3: C1.1, J1.3, J2.3
/CLK: J1.2, J2.2
/DATA: J1.1, R1.1
/SPK+: J1.6, J3.3
/SPK-: J1.5, J3.4
GND: C1.2, J1.4, J2.1, J2.5, J2.6
unnamed: J2.4, R1.2
