Tympan/Earpiece_BTE-RIC_V1/Electrical Design/KICAD_ BTE_FLEX/Tympan_BTE_Flex.kicad_pcb

## KiCad design Electrical Design/KICAD_ BTE_FLEX/Tympan_BTE_Flex.kicad_pcb (2019-09-18)

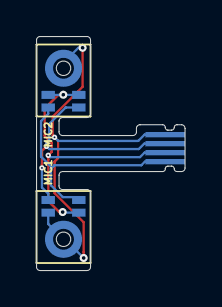
[picture p39: board Tympan_BTE_Flex.kicad_pcb from below]

Board: 2 copper layers, 8.2 x 13.0 mm, 3 parts (3 on the bottom side), 4 nets.

Parts:
FPC1: FPC_MALE; 10062827-0410EDHLF FPC Flex
MIC1, MIC2: IM69D130

Connections:
/CLK: FPC1.3, MIC1.3, MIC2.3
/DATA: FPC1.1, MIC1.1, MIC2.1
GND: FPC1.4, MIC1.4, MIC1.5, MIC2.5
VDD: FPC1.2, MIC1.2, MIC2.2, MIC2.4
