Tympan/Earpiece_BTE-RIC_V1/(commit log)

2019-07-11 Initial Release for Review of Mechanical Design
    [7146-01006_MIC_GASKET_Rev-D.DXF, 7146-01007_PCB FOR BTE_Rev-A.DXF, 7146-01008 STRAIN RELIEF_Rev-B.DXF, 7146-01008_STRAIN_RELIEF_Rev-B.STEP, 7146-01014_ENCLOSURE_LEFT_Rev-A.STEP, 7146-01015_ENCLOSURE_RIGHT_Rev-A.STEP, Earpiece_BTE-RIC_V1.xlsx]
2019-07-16 Corrected faulty faces including a knife edge near the lip.
    Other Solidworks design files have not yet been updated, as they will be corrected soon.
    [7146-01015_ENCLOSURE_RIGHT_Rev-A.STEP, 7146-01015_ENCLOSURE_RIGHT_Rev-B.STEP]
2019-07-16 Changed FPC connector, which affected many parts.
    [7146-01003_FLEX CIRCUIT_Rev-E.DXF, 7146-01007_PCB FOR BTE_Rev-A.DXF, 7146-01007_PCB FOR BTE_Rev-C.DXF, 7146-01008_STRAIN_RELIEF_Rev-B.STEP, 7146-01008_STRAIN_RELIEF_Rev-H.STEP, Earpiece_BTE-RIC_V1.xlsx]
2019-07-24 Fixed hanging chad on Right Enclosure
    [7146-01015_ENCLOSURE_RIGHT_Rev-B.STEP, 7146-01015_ENCLOSURE_RIGHT_Rev-C.IGS, 7146-01015_ENCLOSURE_RIGHT_Rev-C.STEP, 7146-01015_ENCLOSURE_RIGHT_Rev-C_Imported as STP.SLDPRT]
2019-09-18 Adding Kicad Circuit Design for Flex PCB
2019-09-18 Adding design files for the flexi board
    [Tympan_BTE_Flex-B_Cu.gbr, Tympan_BTE_Flex-B_Mask.gbr, Tympan_BTE_Flex-B_Paste.gbr, Tympan_BTE_Flex-B_SilkS.gbr, Tympan_BTE_Flex-Eco1_User.gbr, Tympan_BTE_Flex-Edge_Cuts.gbr, Tympan_BTE_Flex-F_Cu.gbr, Tympan_BTE_Flex-F_SilkS.gbr]
2019-09-18 Updated dates and version
    [Tympan_BTE_Flex.kicad_pcb, Tympan_BTE_Flex.sch]
2019-09-19 Changed name of gerber file for clarity
    [Tympan_BTE_Flex-Stiffener.gbr]
2019-09-19 Added Rigid PCB design
    There are two PCB layouts. One is an array of 5 boards, the other is just one
    [Tympan_BTE_RIGID-B_Cu.gbr, Tympan_BTE_RIGID-B_Mask.gbr, Tympan_BTE_RIGID-B_Paste.gbr, Tympan_BTE_RIGID-B_SilkS.gbr, Tympan_BTE_RIGID-Edge_Cuts.gbr, Tympan_BTE_RIGID-F_Cu.gbr, Tympan_BTE_RIGID-F_Mask.gbr, Tympan_BTE_RIGID-F_Paste.gbr]
2019-09-20 Updated SW pad locations and Wiring Overview to match actual PCB layout
    Updated pad locations in SW
    Updated wiring overview for rigid PCB to match actual PCB layout
    [7146-01007_PCB FOR BTE_Rev-D.DXF]
2019-09-20 Labeled wire colors and swapped the +- speaker connections
    [Tympan_BTE_RIGID.kicad_pcb, Tympan_BTE_RIGID.sch, Tympan_BTE_RIGID_Array.kicad_pcb]
2019-11-01 Corrected wiring diagram
    Corrected wiring diagram based on revisions to the earpiece shield, in which the USB mini pinout changed.
2020-09-10 changed file extensions from upper case to lower case
    This will work for the solidworks zipped folder, but maybe not the others?
2020-09-10 Changed file extensions to lower case
    [7146-01003_FLEX CIRCUIT__Rev-E.dxf, 7146-01006_MIC_GASKET__Rev-D.dxf, 7146-01007_PCB FOR BTE__Rev-C.dxf, 7146-01007_PCB FOR BTE__Rev-D.dxf, 7146-01008 STRAIN RELIEF__Rev-B.dxf, 7146-01008_STRAIN_RELIEF__Rev-H.step, 7146-01014_ENCLOSURE_LEFT__Rev-A.step, 7146-01015_ENCLOSURE_RIGHT__Rev-C.igs]
2020-09-16 added specifications to the PCB schematics and made pdf of schem
    [Tympan_BTE_Flex.sch, Tympan_BTE_RIGID.sch]
2021-03-04 Updated strain relief and added BOM for earpiece
    Updated strain relief and added BOM for earpiece
    [7146-01008_STRAIN_RELIEF__Rev-H.step, 7146-01008_STRAIN_RELIEF__Rev-I.STEP, BOM-7146-0100_BTE_Assembly.xlsx]
2021-03-08 Upload Mic gasket without slots
    [7146-01006_MIC_GASKET__Rev-D.dxf, 7146-01006_MIC_GASKET__Rev-F.DXF]
2022-07-13 Fixed issue where both mics needed to be plugged in at once. Now only the left PDM mic is used.
    [EarpieceManualMixing_wSD.ino, MixerFunctions.h, SerialManager.h]
2022-09-21 Updated SW Pack and Go zip file for Earpice CAD
2022-10-19 Adding a floder for test firmware
    first example of BTE production test firmware
    [Tympan_BTE_Flex_BOM.csv]
2022-11-16 Started Building Assembly Guide
    The CS-44 placement is critical to all of the parts fitting. It is, basically, the keystone of the entire build.
